mithro/tinytapeout-demoboard-to-raspi/TTDB_2_Raspi.kicad_pcb

## KiCad design TTDB_2_Raspi.kicad_pcb (2026-09-29)

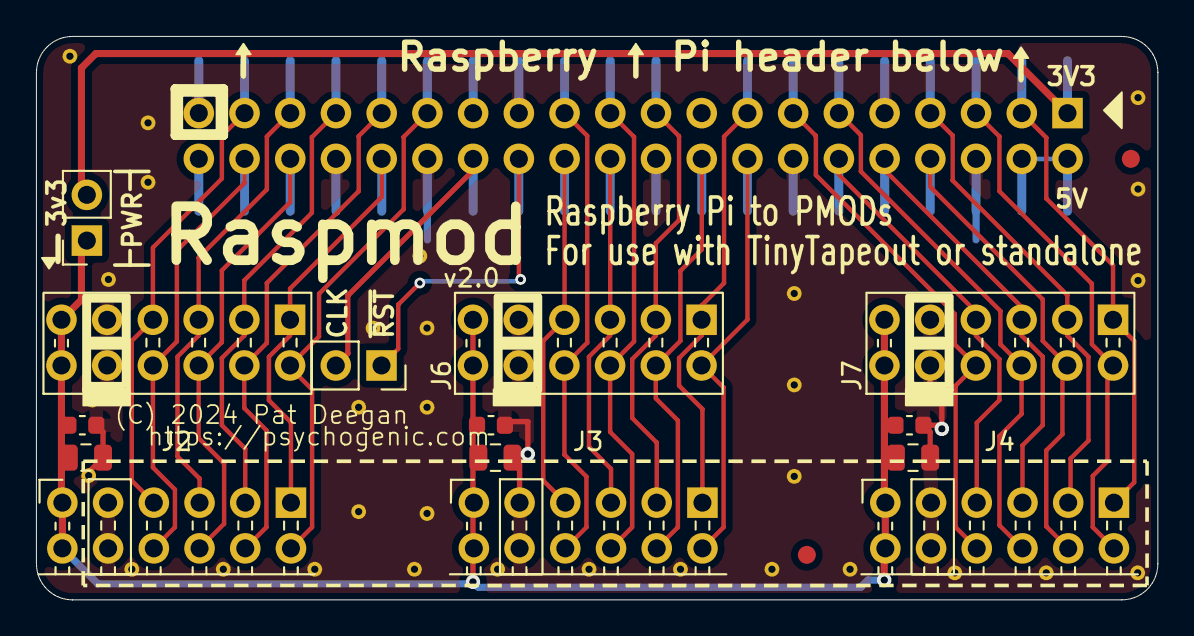
[picture p4: board TTDB_2_Raspi.kicad_pcb from above]

Board: 2 copper layers, 62.3 x 31.3 mm, 48 parts (0 on the bottom side), 30 nets.

Parts:
C2, C4, C6: C_10u_0805_35V; C_0805_2012Metric
C3, C5, C7: C_1u_0603_50V; C_0603_1608Metric
FID1, FID2: Fiducial; Fiducial_1mm_Mask2mm
J1: CS25582-40G-M36-0A; PinSocket_2x20_P2.54mm_SMD_CS25582_Under
J2, J3, J4: 61301221021; PinHeader_2x06_P2.54mm_PMODPeriph2B_TopRA_Mirror
J5, J6, J7: 613012243121; PinSocket_2x06_P2.54mm_PMODHost1A_VERT
J8, J11: Conn_01x02; PinSocket_1x02_P2.54mm_Vertical
STITCH1, STITCH2, STITCH3, STITCH4, STITCH5, STITCH6, STITCH7, STITCH8, STITCH9, STITCH10, STITCH11, STITCH12, STITCH14, STITCH21, STITCH26, STITCH27, STITCH28, STITCH29, STITCH30, STITCH31, STITCH31#2, STITCH31#3, STITCH31#4, STITCH31#5, STITCH31#6, STITCH31#7, STITCH31#8, STITCH31#9, STITCH31#10, STITCH31#11, STITCH31#12: StitchingVia-0.4mmDrill

Connections:
+3V3: C2.1, C3.1, C4.1, C5.1, C6.1, C7.1, J2.6 (VCC), J2.12 (VCC), J3.6 (VCC), J3.12 (VCC), J4.6 (VCC), J4.12 (VCC), J5.6 (VCC), J5.12 (VCC), J6.6 (VCC), J6.12 (VCC), J7.6 (VCC), J7.12 (VCC), J11.1
/CLK: J1.28 (ID_SC_I2C0/GPIO01), J8.2
/P1_1: J1.32 (GPIO12/PWM0), J2.1 (IO1), J5.1 (IO1)
/P1_2: J1.33 (GPIO13/PWM1), J2.2 (IO2), J5.2 (IO2)
/P1_3: J1.35 (GPIO19/SPI1_MISO/PCM_FS), J2.3 (IO3), J5.3 (IO3)
/P1_4: J1.37 (GPIO26/SDIO_DAT2), J2.4 (IO4), J5.4 (IO4)
/P1_5: J1.29 (GPCLK1/GPIO05), J2.7 (IO5), J5.7 (IO5)
/P1_6: J1.31 (GPCLK2/GPIO06), J2.8 (IO6), J5.8 (IO6)
/P1_7: J1.36 (GPIO16/SPI1_~CE2), J2.9 (IO7), J5.9 (IO7)
/P1_8: J1.38 (GPIO20/SPI1_MOSI/PCM_DIN/PWM1), J2.10 (IO8), J5.10 (IO8)
/P2_1: J1.15 (GPIO22/SDIO_CLK), J3.1 (IO1), J6.1 (IO1)
/P2_2: J1.19 (MOSI_SPI0/GPIO10), J3.2 (IO2), J6.2 (IO2)
/P2_3: J1.22 (GPIO25/SDIO_DAT1), J3.3 (IO3), J6.3 (IO3)
/P2_4: J1.24 (~CE0_SPI0/GPIO08), J3.4 (IO4), J6.4 (IO4)
/P2_5: J1.16 (GPIO23/SDIO_CMD), J3.7 (IO5), J6.7 (IO5)
/P2_6: J1.18 (GPIO24/SDIO_DAT0), J3.8 (IO6), J6.8 (IO6)
/P2_7: J1.21 (MISO_SPI0/GPIO09), J3.9 (IO7), J6.9 (IO7)
/P2_8: J1.23 (SCLK_SPI0/GPIO11), J3.10 (IO8), J6.10 (IO8)
/P3_1: J1.3 (SDA_I2C1/GPIO02), J4.1 (IO1), J7.1 (IO1)
/P3_2: J1.7 (GPCLK0/GPIO04), J4.2 (IO2), J7.2 (IO2)
/P3_3: J1.10 (GPIO15/UART_RXD), J4.3 (IO3), J7.3 (IO3)
/P3_4: J1.12 (GPIO18/SPI1_~CE0/PCM_CLK/PWM0), J4.4 (IO4), J7.4 (IO4)
/P3_5: J1.5 (SCL_I2C1/GPIO03), J4.7 (IO5), J7.7 (IO5)
/P3_6: J1.8 (GPIO14/UART_TXD), J4.8 (IO6), J7.8 (IO6)
/P3_7: J1.11 (GPIO17/SPI1_~CE1), J4.9 (IO7), J7.9 (IO7)
/P3_8: J1.13 (GPIO27/SDIO_DAT3), J4.10 (IO8), J7.10 (IO8)
/~RST: J1.26 (~CE1_SPI0/GPIO07), J8.1
GND: C2.2, C3.2, C4.2, C5.2, C6.2, C7.2, J1.6 (GND), J1.9 (GND), J1.14 (GND), J1.20 (GND), J1.25 (GND), J1.30 (GND), J1.34 (GND), J1.39 (GND), J2.5 (GND), J2.11 (GND), J3.5 (GND), J3.11 (GND), J4.5 (GND), J4.11 (GND), J5.5 (GND), J5.11 (GND), J6.5 (GND), J6.11 (GND), J7.5 (GND), J7.11 (GND), STITCH1.1, STITCH2.1, STITCH3.1, STITCH4.1, STITCH5.1, STITCH6.1, STITCH7.1, STITCH8.1, STITCH9.1, STITCH10.1, STITCH11.1, STITCH12.1, STITCH14.1, STITCH21.1, STITCH26.1, STITCH27.1, STITCH28.1, STITCH29.1, STITCH30.1, STITCH31.1, STITCH31#2.1, STITCH31#3.1, STITCH31#4.1, STITCH31#5.1, STITCH31#6.1, STITCH31#7.1, STITCH31#8.1, STITCH31#9.1, STITCH31#10.1, STITCH31#11.1, STITCH31#12.1
unnamed: J1.2 (5V), J1.4 (5V)
VDD: J1.1 (3V3), J11.2
