mithro/tinytapeout-demoboard-to-raspi/(commit log)

2026-09-29 scripts: the direct-on-GPIO variant, as a program over upstream's board
    make_direct.py rewrites the board and the schematic Pat published into a
    variant that sits on a Raspberry Pi's 40-pin header and lies flat beside
    the FPGA board: J1 becomes a low-profile SMT socket on the underside, the
    three underside plugs become right-angle headers on top, the pin-40 end
    is cut 10 mm short of the Pi's port stack, and J9, J10 and SW1 go. Every
    edit is string surgery on the s-expressions, so the files stay in KiCad
    10's format and every kept pad stays where it was.
    restitch.py puts a stitching via into any ground pour cluster the edit
    leaves stranded, read off the refilled polygons; check_direct.py pr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
    [check_direct.py, make_direct.py, restitch.py]
2026-09-29 board: the direct variant, made by scripts/make_direct.py
    The output of scripts/kicad10.sh build over commit 0dae4bf's files, with
    the pour refilled by KiCad 10. DRC finds no unconnected items and no
    schematic parity issues; scripts/check_direct.py finds every kept pad
    where upstream had it, on its net, J1's forty SMT pads beside their
    holes, and an outline 10 mm shorter on the left and nothing else.
    The one change of net is J1 pin 17, the Pi's second 3V3 pin, left
    unconnected: the 3V3 rail moved from the back of the top edge, where the
    socket's pads now are, to the front, and the strip of ground pour between
    it and the pin row is the only way out for the outer row's ground pins.
    A stub fr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
    [TTDB_2_Raspi.kicad_pcb, TTDB_2_Raspi.kicad_sch]
2026-09-29 images: the direct variant rendered, top, underside and from above
    scripts/kicad10.sh images: KiCad 10's ray-traced renders with the stock
    3D models, and the copper plot as SVG. The SMT socket has no model, so
    the underside shows its pads.
    Claude-Session: https://claude.ai/code/session_01Qe7kZB4E45ptN8w9dTEZEk
